zarpli/PS-WTX500/(threads)

Thread 1 (2020-07-02):

13 pin DIN connector

RFmanNJ, 2020-07-02:
You did is an awesome work!
On the DIN connector shown below:
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

How and what did you connect your the two RCA connectors?
Did you connect SW and FL speakers only from the DIN connection to RCA connectors? Or did you connect to 13P.ST ACON1 connector in your subwoofer?

I am about to do this to my subwoofer as well.

Thank you,

zarpli, 2020-07-02:
hi,
you can send the analog audio signals through the DIN connector, I do not have the DIN connector cable, that is why I connected the audio signals directly to the PCB.

Please share photos or video of your hack :)

RFmanNJ, 2020-07-02:
Definitely, you did all the work. I am just following your foot step. I appreciate your response. I will take a lot of pictures. I didn't know how to contact you. So, I posted on the issue.

You are the man!

RFmanNJ, 2020-07-18:
Zarpli,
I didn't record video. But I was successfully implement the code and modified the subwoofer. I only tried the subwoofer but it's working like a charm! Great work.

zarpli, 2020-07-18:
I'm glad you did the hack, I hope later you can share a photo, best regards

Thread 2 (2020-12-20):

[Q] Help with PS9829B-based samsung amplifier

bademux, 2020-12-20:
Hi,
Thanks for the project, I read description as a good piece of adventure literature!
And I suddenly realized that [Home Theater HT-THQ25](https://www.samsung.com/uk/support/model/HT-THQ25R/ELS/)  (with integrated amplifier and dvd) whait for its time :)
Looks like Samsung create modular products. Mine consists of 3 boards. Main board, PSU and Amplifier.
The interesting part is amplifier it is based on exactly the same PS9829B chip, but it lacks ADC part ( S4560,  AK5384  and AK5381). Amplifier is connected to motherboard via 32 pin FPC cable (please see image below).
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

| name | FPC | rpi |
| --- | --- | --- |
| TMS (MLRCK) | 11 | LRCK |
| BCK | 12 | BCK |
| TSD0 (MSDIN0) | 13 | DOUT |
|  TSD1 (MSDIN1) | 14 | none |
|  TSD2 (MSDIN2) | 15 | none |
| CS | 17 | SPI_CE0  |
|  MOSI (?) | 18 | SPI_MOSI  |
| SCK | 19  | SPI_SCLK  |
 | MISO (?) |  20  | SPI_MISO  |
 | PS-RST (PDN) (?) | 16 | GPIOX  |
P-ON is located on PSU board.

Unfortunately my knowledge in electronics is limited, so I want to ask your opinion about my idea:
Is it worth to try attach raspberry pi to amplifier from HT-THQ25 via i2s (PS9818 datasheet states that it is capable to handle i2s) and control it via SPI?
The full idea is to use 5.1 system with 2.1 mode (unfortunately RPI handles only 2 audio channels over i2s) for [Spotify build in client](https://github.com/dtcooper/raspotify) on RPI.

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

zarpli, 2020-12-21:
> Is it worth to try attach raspberry pi to amplifier from HT-THQ25 via i2s (PS9818 datasheet states that it is capable to handle i2s) and control it via SPI?

Yes, it's possible

> The full idea is to use 5.1 system with 2.1 mode (unfortunately RPI handles only 2 audio channels over i2s) for [Spotify build in client](https://github.com/dtcooper/raspotify) on RPI.

I recommend doing unit experiments, you could start with a Teensy Board that has an excellent audio library. You will be able to do multi-channel testing, although you can use one audio channel and repeat it on the outputs you need using the PS9829B settings.

[https://www.pjrc.com/teensy/](url)

please share your project :)

bademux, 2020-12-22:
Thanks,
Raspberry Pi 1 (or 3) is the only thing I have right now.
Can I please ask you about powering?
I wonder how to power my rpi? Is it possible to power it from standby psu?
Can you please share you scheme?

Closed 2020-12-30.

Thread 3 (2021-11-30):

Different model HT-TXQ120 (equipped with DSP), Same Microcontroller and PWM Modulator

mohrez007, 2021-11-30:
At first, I would like to appreciate your hard work and efforts in sharing your experience which is an awesome project for me as I have the same Samsung Home Theater but a different model (HT-TXQ120) which has an additional part as DSP (TMS320DA601).

I am trying to remove or just ignore this DSP by wiring the Serial Data of ADC (AK5358) as SDTO 0~2 directly to the PWM modulator (Pulsus PS9829B).
But I couldn't find any information in your project about the clock connection of ADC to Arduino (LRCK, BCK). In my model, DSP is controlling the clock of ADC.

Also, you didn't include any code regarding EXT_MUTE and ENCODER pins. I think EX-MUTE and RESET pin is required for power up and down.
So can you answer the above issue and help me to connect without DSP?
I can use Arduino UNO/NANO and raspberry pi 4.

As my Amplifier PCB (PS9829B and TAS5152) is separated from the main PCB then I can bypass it and design a new ADC for feeding the Amplifier. In this case, what is your suggestion? Which ADC can match this system and is easy to program by Arduino?

Thanks in advance for your review and answer.

P.S: This is one of the amazing projects with Arduino to control Audio chips and I want to share the whole experience here. I will surely make a reference for you.
I shared the training manual and some datasheets in this link.
https://drive.google.com/drive/folders/1E7YfVggPZWlfTHFe-jU6epBb4VOzLJik?usp=sharing

Closed 2022-03-15.
